markstanners1-arch/protocol-asic/docs/layout/render_3nov_v02_3eng.jpg

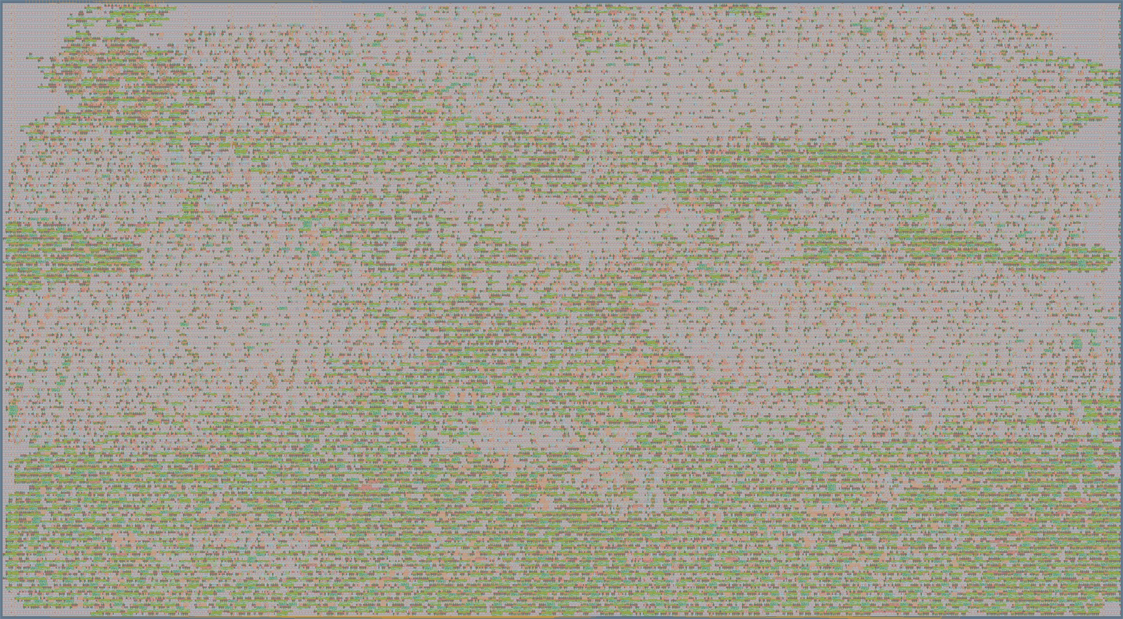
docs/layout/render_3nov_v02_3eng.jpg
