markstanners1-arch/protocol-asic/docs/layout/synthesis_3nov_v02_3eng.txt

179. Printing statistics.

=== tt_um_gosforth_protocol_emu ===

        +----------Local Count, excluding submodules.
        |        +-Local Area, excluding submodules.
        |        | 
    24957        - wires
    24992        - wire bits
     2979        - public wires
     3014        - public wire bits
        8        - ports
       43        - port bits
    24973 3.76E+05 cells
      321 4.08E+03   sg13cmos5l_a21o_1
     1302 1.18E+04   sg13cmos5l_a21oi_1
       23   333.85   sg13cmos5l_a21oi_2
      511 7.42E+03   sg13cmos5l_a221oi_1
      880 9.55E+03   sg13cmos5l_a22oi_1
      643 5.83E+03   sg13cmos5l_and2_1
      126  1.6E+03   sg13cmos5l_and3_1
        1   12.701   sg13cmos5l_and3_2
       78 1.13E+03   sg13cmos5l_and4_1
     2007 1.46E+04   sg13cmos5l_buf_1
       40   1814.4   sg13cmos5l_buf_16
      567 5.14E+03   sg13cmos5l_buf_2
      430 6.24E+03   sg13cmos5l_buf_4
      327 7.71E+03   sg13cmos5l_buf_8
     2969 1.45E+05   sg13cmos5l_dfrbpq_1
       24  348.365   sg13cmos5l_dlygate4sd2_1
      356 1.94E+03   sg13cmos5l_inv_1
        5   36.288   sg13cmos5l_inv_2
        1   10.886   sg13cmos5l_inv_4
     1463 2.65E+04   sg13cmos5l_mux2_1
        2   39.917   sg13cmos5l_mux2_2
      523 1.99E+04   sg13cmos5l_mux4_1
     2405 1.75E+04   sg13cmos5l_nand2_1
        9   97.978   sg13cmos5l_nand2_2
      289 2.62E+03   sg13cmos5l_nand2b_1
      744 6.75E+03   sg13cmos5l_nand3_1
      101 1.28E+03   sg13cmos5l_nand3b_1
      234 2.55E+03   sg13cmos5l_nand4_1
     1425 1.03E+04   sg13cmos5l_nor2_1
       20  217.728   sg13cmos5l_nor2_2
      260  2358.72   sg13cmos5l_nor2b_1
        4   50.803   sg13cmos5l_nor2b_2
      415  3764.88   sg13cmos5l_nor3_1
       24   391.91   sg13cmos5l_nor3_2
      153 1.67E+03   sg13cmos5l_nor4_1
       43   936.23   sg13cmos5l_nor4_2
     2545 2.31E+04   sg13cmos5l_o21ai_1
      139 1.26E+03   sg13cmos5l_or2_1
        1   10.886   sg13cmos5l_or2_2
       84 1.07E+03   sg13cmos5l_or3_1
       55  798.336   sg13cmos5l_or4_1
     2969 2.15E+04   sg13cmos5l_tiehi
      250   3628.8   sg13cmos5l_xnor2_1
      205 2.98E+03   sg13cmos5l_xor2_1

   Chip area for module '\tt_um_gosforth_protocol_emu': 376396.675200
     of which used for sequential elements: 145447.747200 (38.64%)
