markstanners1-arch/protocol-asic/docs/layout/synthesis_2nov_v01_filter.txt

179. Printing statistics.

=== tt_um_gosforth_protocol_emu ===

        +----------Local Count, excluding submodules.
        |        +-Local Area, excluding submodules.
        |        | 
    16168        - wires
    16203        - wire bits
     2052        - public wires
     2087        - public wire bits
        8        - ports
       43        - port bits
    16184 2.53E+05 cells
      194 2.46E+03   sg13cmos5l_a21o_1
      834 7.57E+03   sg13cmos5l_a21oi_1
       11  159.667   sg13cmos5l_a21oi_2
      359 5.21E+03   sg13cmos5l_a221oi_1
      586  6357.28   sg13cmos5l_a22oi_1
      432 3.92E+03   sg13cmos5l_and2_1
       90 1.14E+03   sg13cmos5l_and3_1
        1   12.701   sg13cmos5l_and3_2
       38  551.578   sg13cmos5l_and4_1
     1355 9.83E+03   sg13cmos5l_buf_1
        4   181.44   sg13cmos5l_buf_16
      383 3.47E+03   sg13cmos5l_buf_2
      291 4.22E+03   sg13cmos5l_buf_4
      136 3.21E+03   sg13cmos5l_buf_8
     2043    1E+05   sg13cmos5l_dfrbpq_1
      218 1.19E+03   sg13cmos5l_inv_1
        6   43.546   sg13cmos5l_inv_2
        1   10.886   sg13cmos5l_inv_4
     1797 3.26E+04   sg13cmos5l_mux2_1
      266 1.01E+04   sg13cmos5l_mux4_1
     1181 8.57E+03   sg13cmos5l_nand2_1
        1   10.886   sg13cmos5l_nand2_2
      162 1.47E+03   sg13cmos5l_nand2b_1
      337 3.06E+03   sg13cmos5l_nand3_1
       65  825.552   sg13cmos5l_nand3b_1
      176 1.92E+03   sg13cmos5l_nand4_1
      962 6.98E+03   sg13cmos5l_nor2_1
       12  130.637   sg13cmos5l_nor2_2
      177 1.61E+03   sg13cmos5l_nor2b_1
        1   12.701   sg13cmos5l_nor2b_2
      323 2.93E+03   sg13cmos5l_nor3_1
       19  310.262   sg13cmos5l_nor3_2
      103 1.12E+03   sg13cmos5l_nor4_1
       22  479.002   sg13cmos5l_nor4_2
      981  8.9E+03   sg13cmos5l_o21ai_1
       99  898.128   sg13cmos5l_or2_1
       79    1E+03   sg13cmos5l_or3_1
       45  653.184   sg13cmos5l_or4_1
     2043 1.48E+04   sg13cmos5l_tiehi
      205 2.98E+03   sg13cmos5l_xnor2_1
      146 2.12E+03   sg13cmos5l_xor2_1

   Chip area for module '\tt_um_gosforth_protocol_emu': 253170.111600
     of which used for sequential elements: 100084.118400 (39.53%)
