markstanners1-arch/protocol-asic/docs/memory_options.md

# Program memory: flip-flops or SRAM? (2 Nov 2026)

Jane Street: "For instruction memory, SRAM can be more area-efficient than flip-flops.
Tiny Tapeout has examples of SRAM running on this process node you can reference."

## What exists

IHP's open process kit (`IHP-Open-PDK`, `ihp-sg13g2/libs.ref/sg13g2_sram`) has single- and dual-port
SRAM blocks from 64 x 16 up to 8192 x 32. Tiny Tapeout examples: `urish/ttihp-sram-test` (1024 x 8, the
earlier IHP process). Several other entrants to this competition use the 512 x 16 block for programs.

The one that matches us: **`RM_IHPSG13_1P_64x16_c2`**: 64 words x 16 bits, single port.
The Verilog model, LEF and the IHP cell library are copied into `pdk/`.

## Real areas (IHP sg13g2 standard cells, Yosys synthesis, typical corner, before place and route)

| Item | Area |
|---|---|
| One engine as it stands (32 x 16 program memory in flip-flops) | **99,091 um2** |
| The same engine with the program memory taken out | 64,933 um2 |
| so the flip-flop program memory costs | **~34,000 um2 per engine** |
| SRAM block 64 x 16 (236.8 x 64.36 um) | **15,240 um2** |
| One Tiny Tapeout tile (about 202 x 155 um) | ~31,300 um2 |
| Our 6 x 4 allocation | ~750,000 um2 (realistically 60-70 % usable after routing: ~450-525K) |

Full chip estimate with flip-flop memory: 2 engines (~198K) + host port + input filters, about **230K um2**,
roughly a third of the allocation. It fits either way.

## What SRAM would change

- **Saving**: about 19K um2 per engine (34K of flip-flops -> one 15K block each), about 38K for the chip: ~5 %.
  One block can't serve both engines: it reads one word per clock and each engine needs one every tick.
- **Timing**: the block reads on the clock edge (address in, word out after the edge). Our flip-flop memory
  answers at once. The engine would feed the block the *next* program counter so the instruction arrives
  just in time; the host's program writes would share the same port. The model comparison would re-prove it.
- **Layout**: the block is 236.8 um wide, wider than one tile (~202 um), so it spans two tile columns.
- **Check needed**: that the 64 x 16 block is accepted on the CMOS5L shuttle (it was generated in July 2026).

## Decision (2 Nov 2026, Mark): flip-flops for now

Revisit at the layout stage (weeks 6-7). The reasoning, as leaned:

Keep flip-flops for now: simpler, already proven on 4M random clocks, and the chip fits with room to spare.
Switch to SRAM if the layout stage (roadmap weeks 6-7) shows area or routing getting tight, or if a
bigger program memory (e.g. 64 words per engine) becomes worth having. The 64 x 16 block would give each
engine 64 words for less area than today's 32.

## Update, same day: the engine is now SRAM-ready (Mark: "start there now rather than find changing one thing creates a host of issues")

The engine fetches through `src/prog_mem.v`, a one-port memory that reads on the clock, exactly like the IHP block.
Two builds, one switch (`+define+USE_SRAM`):

| Build | Engine logic | Memory | Total per engine |
|---|---|---|---|
| Flip-flops behaving like SRAM (default) | | in the logic | **98,351 um2** |
| IHP `RM_IHPSG13_1P_64x16_c2` | 56,123 um2 | 15,240 um2 | **71,363 um2** |

So SRAM saves about **27,000 um2 per engine, ~54,000 for the chip** (more than the earlier estimate, because the
flip-flop memory also needs its own read selector). Both builds match the Python model on 1.2M random clocks
each, using IHP's own behavioural model for the SRAM, and a planted fetch-timing bug (reading the current
instead of the next address) was caught in both. The host port can now be built once, on SRAM rules.
Still to check before layout: that this block is accepted on the CMOS5L shuttle.

## Evidence from another entry (found 4 Nov 2026)

J.L. Nuijens's competition entry (github.com/JLNuijens/ttihp-cpu-1-1-uart, public) is an **8x4** IHP CMOS5L design with
**four `RM_IHPSG13_1P_512x32_c2_bm_bist` SRAM macros**, and its gds workflow run 39263918387 of 19 Oct 2026 passed all
four jobs: gds, precheck, gl_test, viewer. So the Tiny Tapeout IHP flow does build and precheck designs with IHP SRAM
macros, and 8x4 tiles work in the template (die 1724 x 711 um). The cost is visible in that repo's `src/`: a custom
`config.json` that substitutes the flow's power-grid step (`+OpenROAD.GeneratePDN` -> `Project.ExtendPowerStripes`),
its own `pdn_cfg.tcl` (comment: the CI's unpatched OpenROAD fails with PDN-0232/0233 on the macro grid, so the tile's
Metal4 stripes are run across the macros instead), an `sram_hold.sdc` with hold margins of 0.3 ns, and a Verilog wrapper
that is a behavioural array under `COCOTB_SIM` and a `(* blackbox *)` module for the GDS build. The macro we want,
`RM_IHPSG13_1P_64x16_c2` (no bm_bist), is in the PDK's `libs.ref/sg13g2_sram/verilog` list alongside the bm_bist sizes.
Still open for the Discord: whether that substituted PDN step is the sanctioned route and accepted on the shuttle, or
whether the template has since gained macro support of its own.

## The route is documented and sanctioned (found 4 Nov 2026, evening, on the TT Discord)

Ken Pettit's competition entry PRISM (github.com/kdp1965/ihp-um-janestreet-prism, 8x4, two 512x32 macros as packet
FIFOs; gds + precheck + gl_test + viewer all passed on 15 Oct 2026) comes with a walkthrough, "Dropping a real SRAM macro
into your CMOS5L tile" (https://kdp1965.github.io/ihp-um-janestreet-prism/ihp_sram_macro.html, 29 Sep 2026). It is the
recipe, and it says the Tiny Tapeout maintainers have whitelisted the macro's two marker layers (GDS 25/0 and 16/0) in
the precheck since September 2026 and confirmed on the Discord that a tile may carry any number of Metal4 VPWR/VGND
stripes. So macros are accepted; the Discord question is answered without posting. The recipe, in short:

- PDK: `PDK=ihp-sg13cmos5l`, the SRAM folder `libs.ref/sg13cmos5l_sram` is a symlink to `ihp-sg13g2/libs.ref/sg13g2_sram`.
  Our macro `RM_IHPSG13_1P_64x16_c2` is complete there at the commit the precheck pins (2bbec755): gds, lef, cdl, doc,
  verilog and three libs. Datasheet: 64 x 16, column mux 2, one port, **236.80 x 64.36 um = 15,240 um2**, one-cycle
  data access, pins A_CLK, A_MEN, A_REN, A_WEN, A_ADDR[5:0], A_DIN[15:0], A_DOUT[15:0], A_DLY (**must be tied 1**); no
  bit mask and no BIST port on this size. Three of them: 45.7K um2 against 102K for the flip-flop stores, so about
  56K um2 (6 % of the 6x4 core) saved while doubling every program to 64 words.
- RTL: instantiate by name, `(* blackbox *)` header for synthesis, the PDK behavioural model (`-DFUNCTIONAL`) for RTL and
  gate-level simulation (the GL netlist keeps the macro as a black box, so the GL test needs the model too).
- `config.json`: a `MACROS` block (gds, lef, cdl as spice, libs mapped onto LibreLane's corner names, one instance per
  hierarchical path with location and orientation), a 2 um macro halo, `ROUTING_OBSTRUCTIONS` on Metal2-4 over the
  footprint, and the power grid made to land on the macro's vertical Metal4 supply columns (VDD!, VDDARRAY!, VSS!):
  `FP_PDN_MULTILAYER 0`, width 2.1, spacing 3.52, pitch 44.96, offset 6.15, macro at x = 3.36 for the 512x32; **read the
  64x16's LEF for its own column positions** before copying numbers. `PDN_MACRO_CONNECTIONS` two lines per instance.
- Sign-off: Magic DRC off and KLayout DRC on with the CMOS5L deck (Magic reports illegal overlaps at the VDD/VDDARRAY
  break that are not real), LVS needs the cdl, antenna diodes on the macro inputs if the report asks, and check in the
  OpenROAD GUI that every stripe crossing the macro sits on a column: an unfed macro passes DRC and LVS and is a brick.
- Tests: write/read-back with the one-cycle latency, on RTL and on gates. Our model already behaves this way
  (`USE_SRAM=1` in cosim), so the engine side needs no change.

Decision still Mark's: it is a layout-only change (no ISA change) but it reopens the proven 6x4 layout, so it goes with
the ISA v0.3 bundle if that happens, not on its own.
