markstanners1-arch/protocol-asic/docs/bench/eth_10mbit_scope_3.png

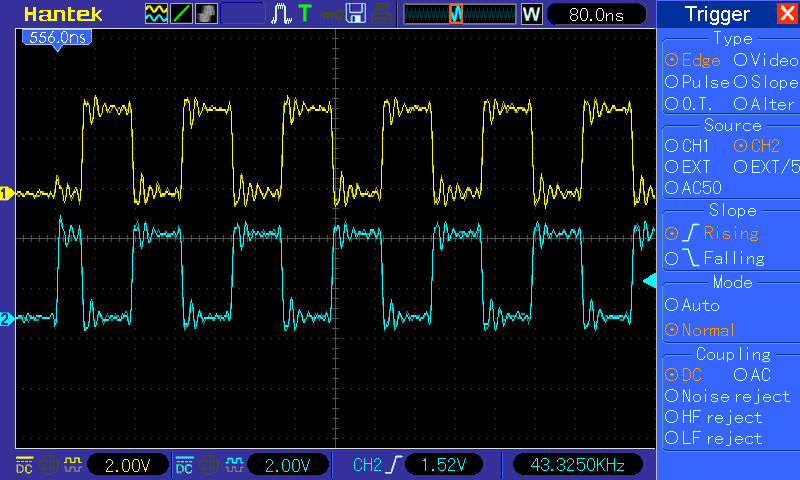
docs/bench/eth_10mbit_scope_3.png
