markstanners1-arch/protocol-asic/docs/bench/i2c_scope_1.png

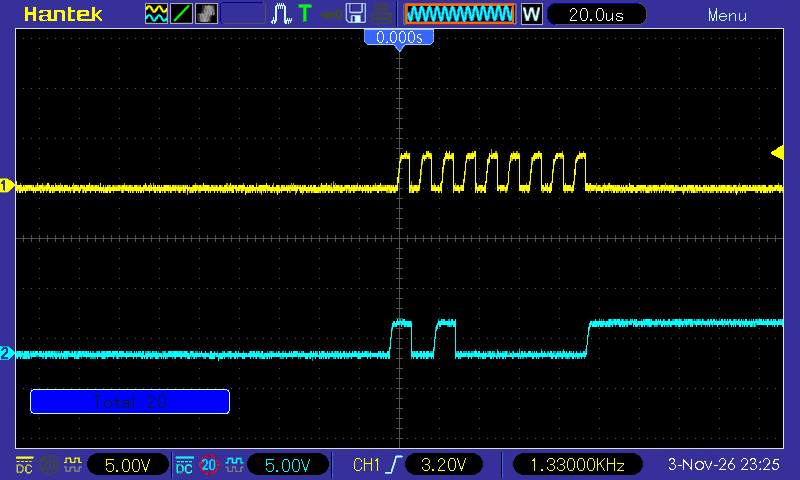
docs/bench/i2c_scope_1.png
