markstanners1-arch/protocol-asic/docs/bench/sp107e_bits_200ns_direct.png

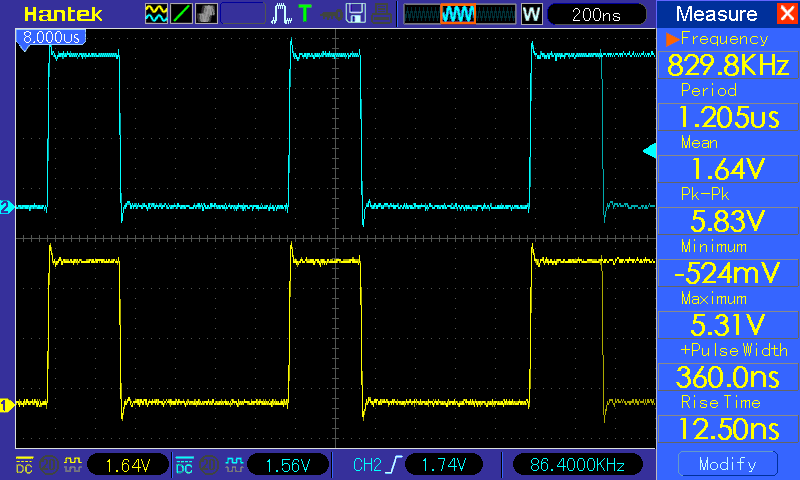
docs/bench/sp107e_bits_200ns_direct.png
