markstanners1-arch/protocol-asic/docs/bench/sp107e_bits_200ns_divider.png

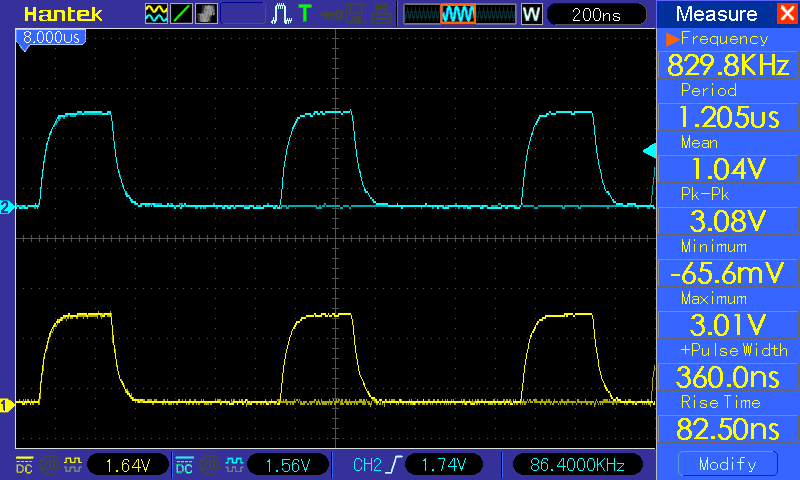
docs/bench/sp107e_bits_200ns_divider.png
