markstanners1-arch/protocol-asic/docs/bench/sp107e_frame_4us.png

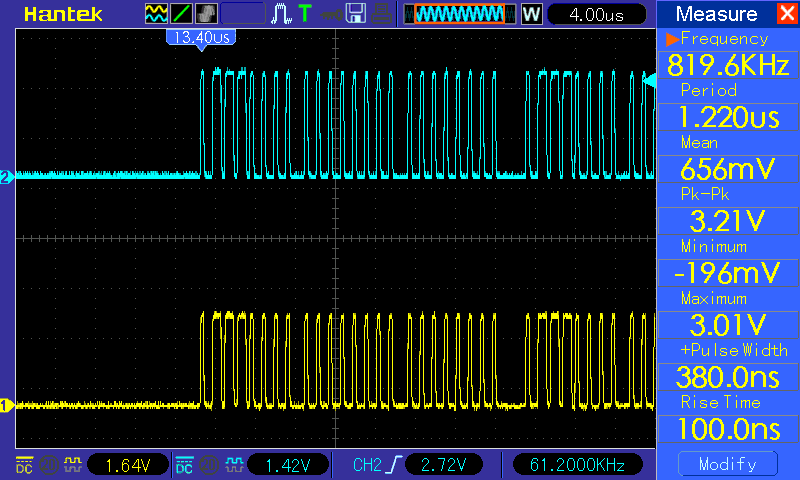
docs/bench/sp107e_frame_4us.png
