markstanners1-arch/protocol-asic/(commit log)

2026-11-02 UART transmitter and self-checking test bench
2026-11-02 Test runner and size check; UART passes, test proven to catch bugs
2026-11-02 Go Board bench test: hello over USB serial using uart_tx; simulated and built
2026-11-02 Go Board: flashed, hello test works on real hardware; flash/listen/driver-check scripts
2026-11-02 Go Board nonstop test: 4288 lines, all correct
2026-11-02 ISA v0.1, Python assembler and engine model; UART program matches uart_tx.v every frame; TIME measures bit time exactly
2026-11-02 Trim round 1: shared pin reader, shifter and pin writer; 7168 -> 5930 gates; re-proved on 2M clocks
2026-11-02 SPI host port and whole chip (two engines, registers, pin map); end-to-end SPI test incl. engine B measuring engine A's UART; 4 planted bugs caught
2026-11-02 Go Board pin file: PMOD connector and UART RX pins (two sources agree)
2026-11-02 Segment 1: Go Board SPI host-port bench test + ESP32 test sketch; simulated to 4.2 MHz
2026-11-02 Host port: MISO changes only after falling edges (bench bug: ESP32 samples late); late-sampling hosts in both test benches; bench: 0 errors in 15,372 checks to 4 MHz
2026-11-02 Notes: EN capacitor fixed ESP32 auto-upload
2026-11-02 Glitch filter: spec, model, Verilog, cosim; bench bounce meter on the Go Board: 84 presses, filter cleans every bounce, delays match design
2026-11-02 MachXO3L starter kit: free-tool flow proven (SRAM load), Hello test; serial link DNI on the kit, headers unpopulated
2026-11-02 Whole chip on the MachXO3L kit (J4): build, wrapper test passes, ESP32 whole-chip sketch
2026-11-02 Whole chip runs on real hardware (MachXO3L + ESP32): PASS at 3 baud rates; MachXO free tools need -nolutram
2026-11-02 Glitch filter in the chip (FILTER register 0x29), measure_pulse program, chip test: glitch rejected, pulse measured; MachXO3 build updated
2026-11-02 ESP32 chip test: hardware glitch-filter test (pulses on engine pin 15 via GPIO17); measure_pulse in programs.h
2026-11-02 Glitch filter proven on hardware: glitch rejected, pulse measured; pin-level diagnostic; Serial2/GPIO17 fix
2026-11-02 Cyclone IV Quartus build (72%, M9K program memories, Fmax 53.9 MHz); I2C and SPI master programs with model slaves and tests; chip_test parameterised on the chip clock
2026-11-02 I2C bus watcher (engine B) proven on the model and on the whole chip with a bench slave; chip test resets FILTER before I2C
2026-11-02 ISA v0.2: side_dir bit (side-set writes pin directions); I2C master open drain with clock stretching; proven on model, cosim and whole chip with planted bugs
2026-11-02 v0.2 engine passes on the MachXO3L kit (0 problems); FPGA builds redone; ESP32 I2C bench test (ESP32 as slave) ready to run
2026-11-02 I2C on real wires PASS: engine A master, engine B watcher, ESP32 slave; ESP32 slave preloads its reply (no stretch on the original ESP32); rerun.ps1 takes -Cmd
2026-11-03 I2C with clock stretching on real wires PASS (UNO R3 slave, repeated START); UNO slave sketch; test data last byte 0x7E; external-slave mode 'n'
2026-11-03 Night handover 3 Nov: CLAUDE.md state, 74HC595 SPI bench test (LEDs still dark), ESP32 sketch SPI mode 's'
2026-11-03 I2C master 19 words: one xfer routine with wire read-back (arbitration); model, chip and ESP32 tests updated; specs review and pinch verdict
2026-11-03 Four engines: NENG parameter, 16-bit host command, ID register 0x2A, priority chain; tb/sketch/docs/TT repo updated; FPGA tops at 2 engines
2026-11-03 Bench wiring sheet docs/bench_wiring.md
2026-11-03 Bench wiring sheet as a landscape PDF (docs/bench_wiring.pdf, generator docs/make_bench_wiring_pdf.py)
2026-11-03 Wiring sheet PDF: column key added
2026-11-03 Wiring sheet rebuilt as FROM -> TO -> AND rows, one wire per row, four pages
2026-11-03 ESP32 scripts find the CH340 port automatically (COM12 after the USB replug); COM7 removed from docs
2026-11-03 Host port v0.2 PASS on hardware; bench helpers p/q/l in the sketch; wiring sheet troubleshooting section
2026-11-03 I2C PASS on the rebuilt bench (19-word master, two-byte host port); b/k bench commands; wiring sheet: go by hole number
2026-11-03 I2C PASS with the UNO slave on the rebuilt bench
2026-11-03 SPI to the 74HC595 PASS on the rebuilt bench; LED walk command; CLAUDE.md state
2026-11-03 LED note on the wiring sheet; 595 walk seen working
2026-11-03 Cyclone IV pins assigned from the board's silkscreen, build 71 % / 53.4 MHz; wiring sheet section 5
2026-11-03 I2C address scan command in the sketch
2026-11-04 4 Nov: keypad scanner program, model test (planted bug caught), sketch command y, wiring sheet section 6; precheck PASS
2026-11-04 4 Nov: keypad PASS on the kit; sketch command e (live pin watch) found the open rows; wiring sheet and README
2026-11-04 4 Nov: wiring sheet section 7, what is plugged in now (no double booking of J4 holes)
2026-11-04 4 Nov: I2C leads to the UNO confirmed by -Cmd n PASS; section 7 updated
2026-11-04 4 Nov: NEC infrared remote decoder (29 words), model test at both dividers with planted bug caught, sketch commands m and j, PASS on the kit with a scripted 12-button sequence; code table, wiring she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
2026-11-04 4 Nov: NEC infrared transmitter (31 words) and its model test: carrier, frame timing, independent decoder, end-to-end through ir_nec.asm at 12 and 50 MHz, planted bug caught; sketch command t (loopba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
2026-11-04 4 Nov: IR transmitter bench PASS (6 of 6 frames through the emitter and receiver); wiring sheet, PDF and README
2026-11-04 4 Nov: README, the phone camera app sets off the IR receiver
2026-11-04 4 Nov: IR transmitter checked on the logic analyser: frame as the receiver sees it matches the remote's to within 5 %, decoded word exact
2026-11-04 4 Nov: Pico 2 host (MicroPython): host module, program table, ID test, put/run scripts over serial, wiring sheet section 8
2026-11-04 4 Nov: fix a mangled path in the wiring sheet
2026-11-04 4 Nov: Pico 2 drives the chip: ID 0x0022, IR loopback 6 of 6, remote codes and keypad read back from MicroPython
2026-11-04 4 Nov: Pico keypad rerun clean; README note on the one double report
2026-11-04 4 Nov: AT24C EEPROM test script for the Pico (dry-run against the UNO slave), program labels in pico/programs.py, run.ps1 soft-resets first
2026-11-04 4 Nov: AT24C256 EEPROM PASS from the Pico (probe, page write, write cycle, reads, top of memory, restore), planted bug caught; ground fix noted; pin watcher
2026-11-04 4 Nov: what-is-this-chip demo on the Pico (ID, I2C scan with guesses, pin survey timed by the engines); 0x58 identification page noted
2026-11-04 4 Nov: three- and four-wire bus talk written up (docs/bus_variants.md): 400 pF limit, fire loops, split I2C plan with P82B96
2026-11-04 4 Nov: SRAM macros proven through the TT IHP flow by another entry (8x4, four 512x32 macros); noted in memory_options and README
2026-11-04 4 Nov: UART receive (programs/uart_rx.asm, 13 words): model test at three dividers with a planted bug caught; loopback PASS at four rates and PASS from the Pico's own UART on J4-6 (text, all 256 valu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
2026-11-04 4 Nov: baud measurer PASS from the Pico at nine rates; I2C sniffer script, watcher matches the master in every transaction (EEPROM flaky on the bench, to settle)
2026-11-04 4 Nov: I2C sniffer PASS on the kit at 100 and 400 kHz (watcher equals master every byte and ACK); the dead-analyser clamp found and recorded as a bench rule; EEPROM page 0x0020 blanked again
2026-11-04 4 Nov: Waveshare Pico-DALI2 chosen as the DALI interface; header pins and polarity recorded
2026-11-04 4 Nov: Waveshare Pico-DALI2 pins and polarity
2026-11-04 4 Nov: DALI chip side model-proven (dali_tx 13 words, dali_rx 26 words, model gear test PASS at 12 and 50 MHz with +-5 % gears, three settling times, coding violations; planted bugs caught); Pico scr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
2026-11-04 4 Nov: DALI plan settled: no shield, 3.3 V wire, Cyclone as the chip, Lattice kit and Go Board as gears
2026-11-04 4 Nov: Pico scripts for the parts due 5 Nov (W25Q32 flash via spi_master on pins 4-7, DS3231 + AT24C32, MCP4725 DAC), desk-checked against a fake chip; wiring sheet sections 11-13 and PDF; whatis gue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
2026-11-05 5 Nov: engine / cluster / chip hierarchy explicit (src/cluster.v), host command bits [11:6] = cluster number
    - src/cluster.v: NENG engines of NSLOT=4 slots, NPIN=32 pin bank, setting registers, lowest-engine-wins mux, IRQ OR.
    - src/chip.v: host port, synchronisers + filter, FILTER and ID, NCLUSTER=1 clusters; cluster 1-63 read 0, writes ignored;
    write/pop strobes qualified by a registered cluster select, reads by the direct compare.
    - src/host_spi.v: latches command bits [11:6] as clu.
    - test/tb_chip.v: five checks on cluster numbers 1, 2 and 63. run.sh size: reads all sources, module name from the file.
    - Tests: cosim seeds 1-3 and USE_SRAM=1 seed 4 identical every clock; run_chip NENG=3,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
2026-11-05 5 Nov: ISA v0.3 serialiser, 64-word TX FIFO on engine 0, 32-bit CRC unit on every engine
    - src/serialiser.v, src/crc32.v new; engine.v (SER, TXDEPTH, CRC parameters), cluster.v (registers 0x2B-0x33,
    STATUS bits 14-15), chip.v (TXDEPTH0, SER0, CRC parameters)
    - Encodings: MOV destination 3 (mov ser), WAIT number 24 (serialiser busy), IN source 7 (CRC), TIME action 5
    (crc reset); MOV status bits 8-9. Rules in docs/isa.md, registers in docs/host_port.md
    - Model and assembler updated; model/test_serialiser.py; programs/eth_tx.asm (16 words) added to the program tables
    - Cosim drives an engine with and one without the serialiser and randomises SERCFG, SERDIV, CRCPOLY, CRCINIT:
    1000 x 400 cl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
2026-11-05 5 Nov: MachXO3L kit has two named builds: default (two engines, v0.2) and "ser" (one engine with the serialiser)
    - fpga/machxo3/build.sh: no argument builds build/chip.bit (two engines, no serialiser, no CRC units, 4-word TX FIFOs):
    5,953 of 6,864 LUTs (86 %), 2,087 flip-flops, fmax 28.74 MHz. "ser" builds build/chip_ser.bit (one engine with the
    serialiser, the CRC unit and the 64-word TX FIFO): 4,785 LUTs (69 %), 2,328 flip-flops, fmax 29.63 MHz.
    "load" after either loads SRAM. Both built here; no board loaded.
    - Header of build.sh, README entry and docs/core_design.md describe the two builds.
2026-11-05 5 Nov: three-engine chip on the Mojo v3 at 50 MHz, Pico regression PASS
    fpga/mojo: wrapper, UCF, ISE build script, pin finder. pico/regression.py (the
    ESP32 regression ported) and lead_probe.py. Wiring sheet section 14 and PDF.
    LX9: 74 % LUTs, 90 % slices, minimum period 16.743 ns (59.7 MHz).
    Bench: ID 0x0023, regression PASS 0 problems; planted fault FAIL.
2026-11-05 Mojo v3 builds with the serialiser (ser, clk40), Pico frame sender, Manchester decoder for analyser captures
    fpga/mojo/build.sh: options ser (NENG=2 SER0=1 CRC=1 TXDEPTH0=64) and clk40
    (40 MHz from a DCM_SP); default build NENG=3 SER0=0 CRC=0 TXDEPTH0=4; reports
    kept per build. chip_mojo.v: parameters, DCM option. src/engine.v: $clog2 in
    the TX FIFO width written as a ternary (XST 14.7 rejects it); cosim and the
    whole-chip test pass unchanged. programs/ser_tx.asm, pico/eth_tx.py,
    docs/bench/decode_manchester.py; regression.py takes CHIP_HZ and ENGINES
    from run.ps1 -Pre.
2026-11-05 Serialiser on the Mojo v3: Ethernet frame at 500 kbit/s and a DALI-rate word decoded from analyser captures, PASS
    ser build: NENG=2, 3,815 LUTs, fmax 56.8 MHz; regression PASS at 50 and 40 MHz.
    Captures saved in docs/bench; README entry, wiring sheet section 14 note.
2026-11-05 README: 10 Mbit/s frame count and the Hantek Autoset reading
2026-11-05 5 Nov: wiring sheet notes the MachXO3L kit retired from the bench in favour of the Mojo v3
2026-11-05 5 Nov: wiring sheet section 15, scope setup for a 10 Mbit/s frame on the Mojo (not yet captured)
2026-11-06 6 Nov: wiring sheet, DS3231 module arrived with a CR2032 fitted: 3.3 V only
2026-11-06 Setting registers and read-back mux per engine slot; whole-chip register sweep
    Each eng_slot in cluster.v now holds its engine's setting registers and picks its own
    read-back word by address; the cluster picks one 16-bit word by engine number. Instance
    paths are unchanged (chip.clu[0].u.eng_slot[n].e...).
    Proof of no behaviour change: cosim 1000 x 400 clocks, flip-flop and IHP SRAM memory,
    every clock identical; whole-chip test PASS at NENG=4, 3, 2, LATE=1 and the kit build
    (SER0=0 CRC=0 TXDEPTH0=4). New register sweep in tb_chip.v: a different value in every
    setting register of every slot and one past the last, all read back; passes on the old and
    the new cluster. Five planted bugs in clus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
2026-11-08 identify: blind identification of unknown 3.3 V pins (listen only by default)
    programs/measure_high.asm times high pulses (mirror of measure_pulse). pico/identify_core.py classifies each pin
    (quiet, UART with baud snap, Manchester/DALI, IR NEC, 1-Wire, clocks) and pairs pins into I2C and SPI buses.
    pico/identify.py runs the engines on every input pin; PROBE=True adds an open-drain I2C scan of quiet idle-high
    pairs; SELFTEST=True checks a known 10 kHz clock (GP2) and 115200 UART (GP4). model/test_identify.py: the real
    programs in the model on 12 simulated targets, PASS; planted bugs (measure_high polarity, bit-time tolerance) caught.
2026-11-08 identify: keep raw tick counts (at most 300 per pin) and convert per pin, so the Pico's heap holds; Mojo bench self-test PASS
    Mojo v3, 40 MHz serialiser build (ID 0x0022, two engines), Pico host: pin 15 (GP2, 10 kHz PWM) free-running clock
    10.0 kHz duty 50 %; pin 16 (GP4, 115200 UART) UART 115200, start bit 8.68 us; pins 0-7 quiet high (pull-ups),
    17-19 quiet low (pull-downs). The first run stopped with a MemoryError: every width was kept as a float.
2026-11-08 8 Nov: 10 Mbit/s Ethernet frame captured on the Hantek scope, pictures and README entry
2026-11-08 8 Nov: Cyclone IV three engines at 50 MHz, ESP32 regression PASS
2026-11-08 8 Nov: Cyclone serialiser build at 40 MHz (PLL), two engines, ESP32 regression PASS
2026-11-08 identify: one-wire LED data (WS2811 / WS2812B / SK6812 type) and matching-pin pairs
    Classifier led_1wire: idles low, highs in two tight groups (ratio 1.5-4), bit 1-2.8 us, and the share of long highs
    equals the share of short lows (a long high is always followed by a short low). pair_up reports pins carrying matching
    LED data. model/test_identify.py: four new cases (SP107E as measured on the scope 8 Nov: WS2811, red 0x70, byte and
    pixel gaps; WS2812B rainbow; WS2811 400 kbit/s; a mirrored pair) beside the 12 earlier ones: PASS. Planted bug (long
    lows compared instead of short lows): all four LED cases WRONG.
    Bench, Mojo 40 MHz serialiser build, Pico host: an SP107E LED controller's DAT and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
2026-11-08 8 Nov: identify merged into main (blind identification, LED classifier), README entry
2026-11-08 Receive on engine 0, half duplex: Manchester receiver beside the serialiser (ISA and host port v0.4 additions)
    src/receiver.v: two samples per clock (falling edge via a wrapper latch, rising edge), both before the glitch filter;
    mid-bit edge decoding with the RXGAP threshold in half-clocks; preamble and SFD lock or raw mode; words into engine 0's
    64-word buffer, read by the host from 0x26; WAIT 25 and IRQ for frame ready. Direction changed only by a keyed SERCFG
    write while idle; a change empties the buffer, resets the receiver and stops the serialiser. Registers RXCFG 0x34,
    RXGAP 0x35, RXSTAT 0x36. Model, model/test_receive.py, cosim with receive stimulus (RX_FOCUS), chip test receiving wit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
2026-11-08 duplex: full duplex on engine 0 (16-word transmit / 48-word receive rings, hold register, RXDATA 0x37), hardware preamble (SERCFG [9])
    Keyed idle-only mode in SERCFG [8:7]: transmit, receive, full duplex. Model, cosim (both memories, no-CRC build),
    chip loopback test, 7 planted bugs, local layout clean, bench PASS on the Mojo (pico/fdx_loop.py).
2026-11-08 CLAUDE.md: state brought up to 8 Nov (four-engine TT chip, receive and full duplex, Cyclone, Mojo, Pico), load rules for the Mojo and Cyclone
2026-11-08 README rewritten as a description of the chip as built (features, layout, programs, verification, bench results, FPGA builds, credits); docs made to describe the built chip; decision notes, the DALI 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
2026-11-08 Dallas 1-Wire master (programs/onewire.asm, 22 words), a model DS18B20 and its test, and the Pico script; bench PASS with a DS18B20 on the Mojo
2026-11-09 LCD 1602 (HD44780, 4-bit, write only): programs/lcd1602.asm (28 words), a model HD44780 with datasheet timing checks and its test (4 and 40 MHz PASS, 4 of 4 planted bugs caught), the Pico script; src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
2026-11-09 Ethernet bench: eth_tx.py gains single held lead steps (STEP), link pulses only (FRAMES=0) and a link lead-in (LEAD_MS); pico/eth_loop_rate.py checks 10 Mbit/s output bit for bit through the chip's o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
2026-11-10 Engine 0's buffer 1024 words (8x4 tiles): IHP RM_IHPSG13_1P_1024x16_c2_bm_bist, 512 + 512 in full duplex, SERLEVEL 0x38 and RXWORDS 0x39; FPGA builds keep 64 (TXDEPTH0=64)
    A full-size 1518-byte Ethernet frame now fits whole each way. SERSTAT [6:0] and RXSTAT [14:8] saturate at 127; the
    exact values are in the new registers. Proven: model/test_buffer1024.py (full frames in transmit, receive and full
    duplex with a host as slow as the SPI port; the 64-word build runs dry on the same frame); cosim at 1024 and 64 words,
    flip-flops and IHP's SRAM model, with and without CRC units, long runs that fill and overflow the buffer (4.7 M clocks,
    identical); whole-chip test in five builds; four planted bu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
2026-11-10 pico/rs485_loop.py: UART over RS-485 between two engines through two adapters (rate test, a held level for metering, a level check)
2026-11-10 parts bin: boards from the boxes
2026-11-11 Tidy: private pointers and draft notes out of the public USB files, eth_tx.asm buffer comment, host_port RP2350; CLAUDE.md state (TT main on the 8x4 1024-word chip); pico/netstack.py ARP and ping rep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
2026-11-11 pico/net_loop.py: ARP and ping over the Mojo loopback (host FCS, full duplex, netstack replies); model/pico_sim.py runs Pico host scripts on the engine model (PASS at SERDIV 199 and 999, 7 of 7 plant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
